corecode/current-monitor/hardware/docs/75867.pdf

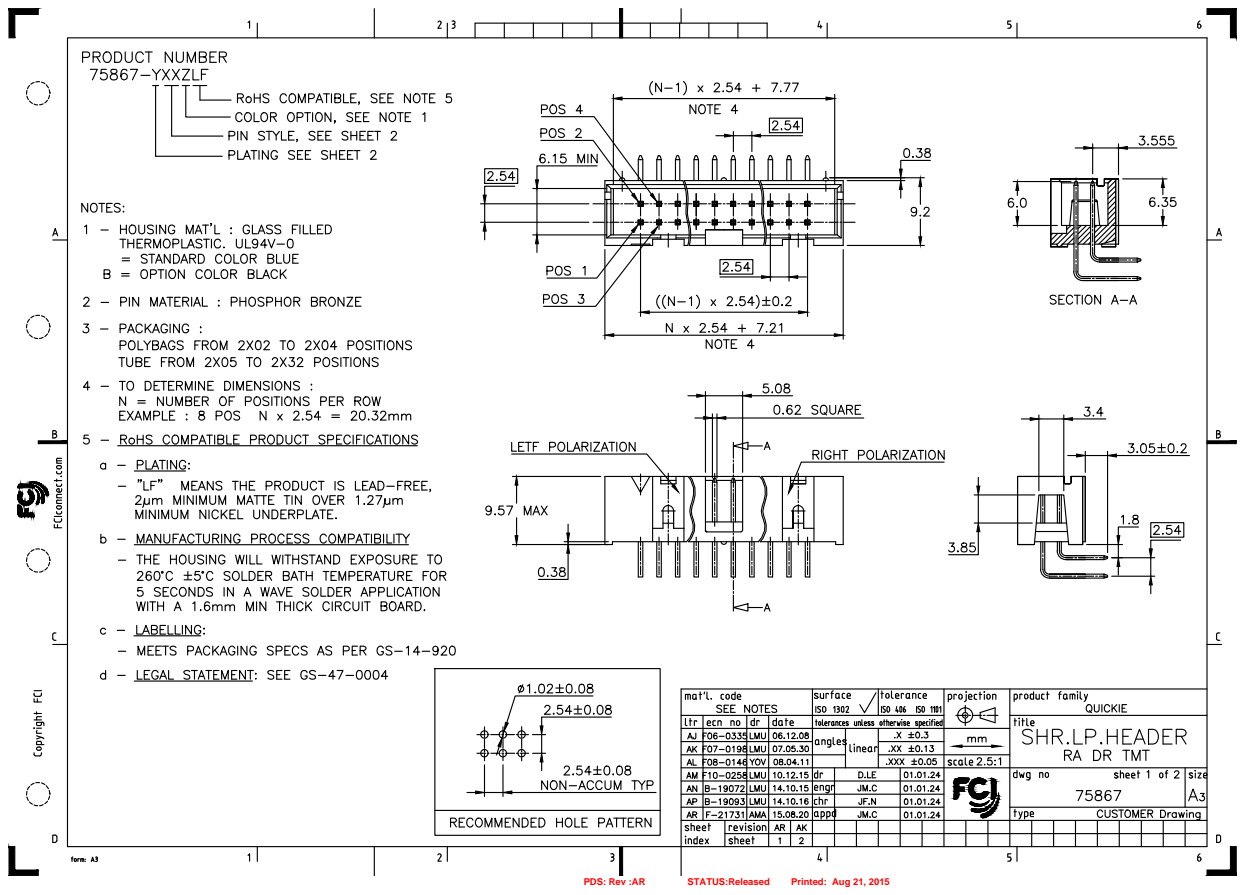
[picture p1: page 1]
PDS: Rev :AR; STATUS:Released; Printed: Aug 21, 2015

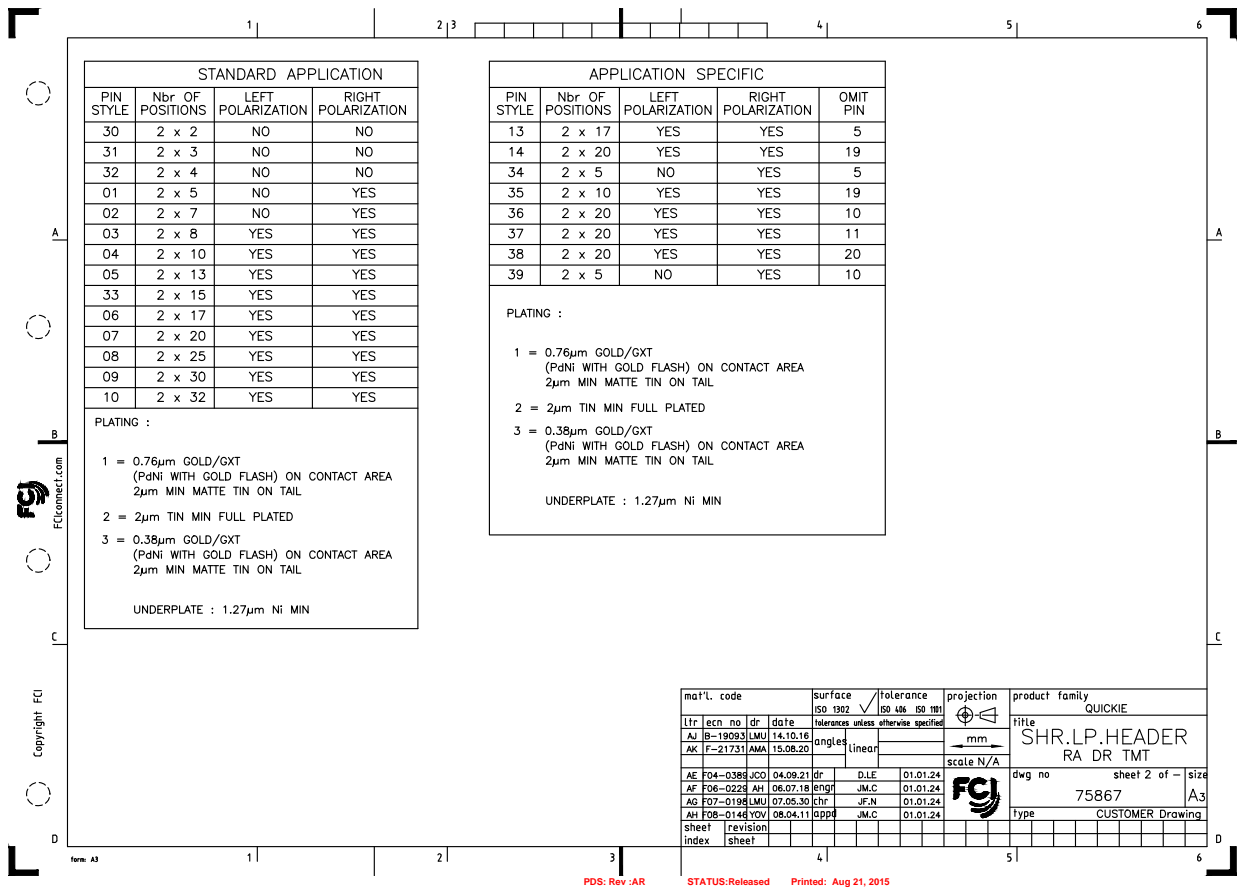
[picture p2: page 2]
PDS: Rev :AR; STATUS:Released; Printed: Aug 21, 2015
