corecode/current-monitor/hardware/calc/difference-amp.asc

I1: current; 0
R1: res; 0.3
R2: res; 1k
R3: res; 10k
R4: res; 1k
R5: res; 10k
R6: res; 100
R7: res; 1Meg
R8: res; 100
R9: res; 1Meg
U1: LT1006
U2: LT1006
V1: voltage; 5
V2: voltage; 50m
V3: voltage; 50m
V4: voltage; 50.008129m
V5: voltage; 50.008129m
Named nets: 0, v+, sense, out, sensem, out2
.tran 1s
