corecode/current-monitor/(threads)

Thread 3 (2017-05-07):

fix usb power in filtering

corecode, 2017-05-07:
put ferrite between input cap and internal power rail, no ferrite on ground.  put ferrite between shield and ground.

Thread 4 (2017-05-07):

stencil8 holes need correctly sized paste layer hole

corecode, 2017-05-07:
