corecode/current-monitor/firmware/ter-u24b.c

#include "font.h"

const struct font1610 ter_u24b = { 14, {
  /* zero */
  { 48, { 8188, 16382, 26115, 17153, 16769, 16577, 16481, 24627, 16382, 8188 }},
  /* one */
  { 49, { 0, 16392, 16396, 16390, 32767, 32767, 16384, 16384, 16384, 0 }},
  /* two */
  { 50, { 24604, 28702, 22531, 19457, 17921, 17153, 16769, 16579, 16510, 16444 }},
  /* three */
  { 51, { 4100, 12294, 24579, 16513, 16513, 16513, 16513, 25027, 16254, 7740 }},
  /* four */
  { 52, { 3840, 3968, 2240, 2144, 2096, 2072, 2060, 2054, 32767, 32767 }},
  /* five */
  { 53, { 4223, 12415, 24641, 16449, 16449, 16449, 16449, 24769, 16257, 7937 }},
  /* six */
  { 54, { 8188, 16382, 24643, 16449, 16449, 16449, 16449, 24769, 16257, 7936 }},
  /* seven */
  { 55, { 7, 7, 1, 1, 31745, 32513, 961, 241, 63, 15 }},
  /* eight */
  { 56, { 7740, 16254, 25027, 16513, 16513, 16513, 16513, 25027, 16254, 7740 }},
  /* nine */
  { 57, { 124, 16638, 16771, 16641, 16641, 16641, 16641, 24835, 16382, 8188 }},
  /* m */
  { 109, { 32752, 32752, 16, 16, 32752, 32752, 16, 48, 32736, 32704 }},
  /* A */
  { 65, { 32764, 32766, 259, 257, 257, 257, 257, 259, 32766, 32764 }},
  /* space */
  { 32, { 0, 0, 0, 0, 0, 0, 0, 0, 0, 0 }},
  /* mu */
  { 181, { 65534, 65534, 2048, 2048, 2048, 2048, 3072, 1536, 4094, 4094 }},
}};
