corecode/current-monitor/(commit log)

2016-09-13 lowspeed current monitor
    [current-monitor.kicad_pcb, current-monitor.sch]
2016-09-13 improve power routing
    [current-monitor.kicad_pcb]
2016-09-14 logo + silkscreen
    [current-monitor.kicad_pcb]
2016-09-14 update gerber settings
    [current-monitor.kicad_pcb]
2016-11-24 add part numbers - some are wrong though
    [current-monitor.sch]
2016-12-16 output readings
    [current-monitor.kicad_pcb, current-monitor.sch]
2017-01-14 start redesign
    [current-monitor.sch]
2017-04-10 redesign for v1 r1
    [current-monitor.kicad_pcb, current-monitor.sch]
2017-04-10 switch datasheet
2017-04-29 BOM for schematic
    [current-monitor.sch]
